grzesl/AngelCarol/README.md

# AngelCarol
AngelCarol is project that contains necessary information to build Angel statue that sings carols.
