grzesl/AngelCarol/Mechanical/Cover.FCStd

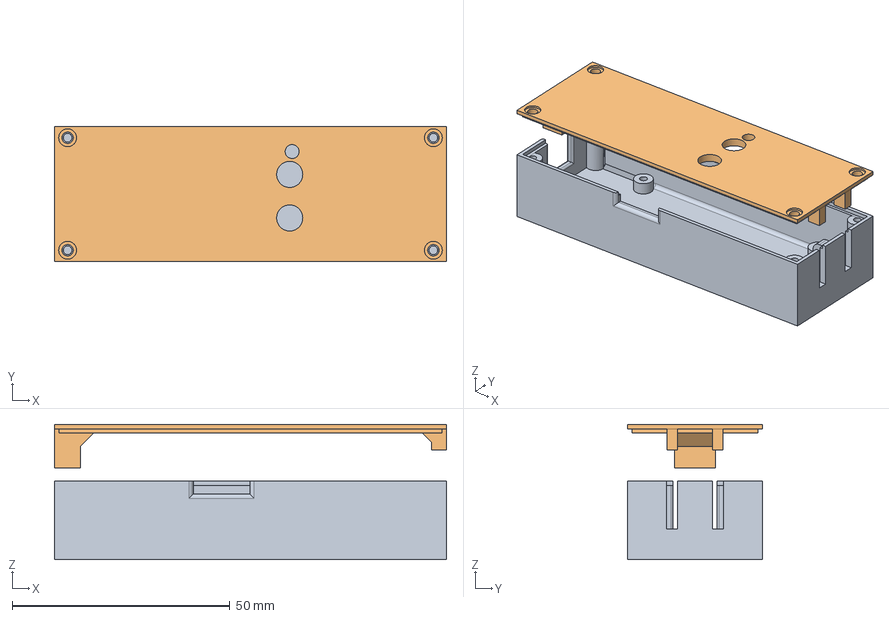
[picture p1: CAD file, 2024-12-02]
Mechanical/Cover.FCStd
90.0 x 31.0 x 31.0 mm
