grzesl/AngelCarol/Mechanical/PkHandler.FCStd

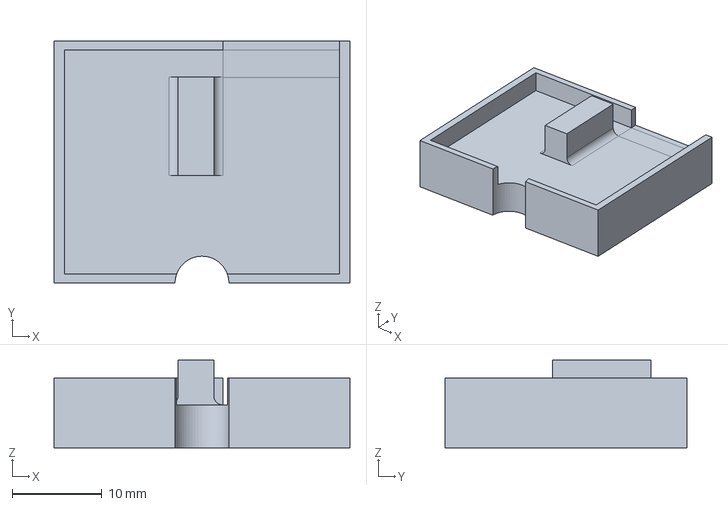
[picture p2: CAD file, 2024-11-30]
Mechanical/PkHandler.FCStd
33.0 x 27.0 x 9.80 mm
