grzesl/AngelCarol/Hardware/AngelCarol.kicad_pcb

## KiCad design Hardware/AngelCarol.kicad_pcb (2024-11-05)

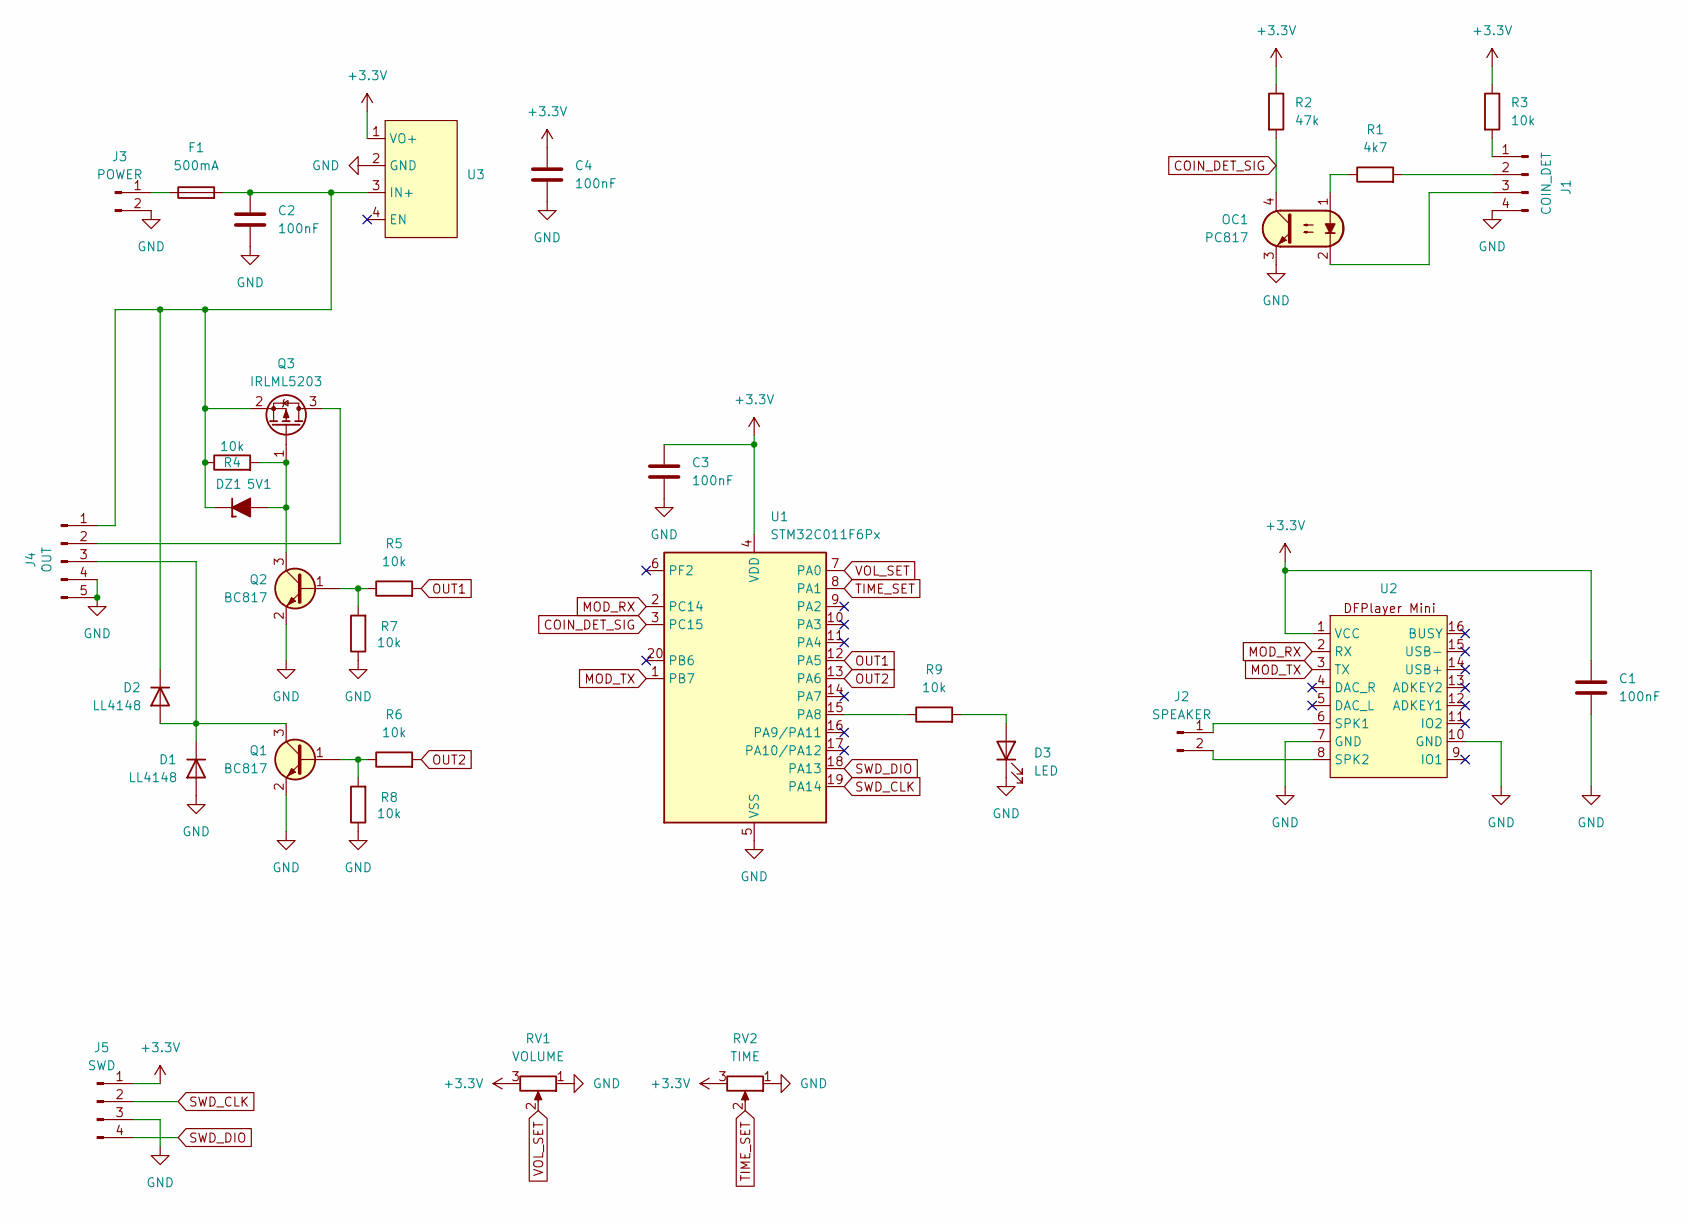
[picture p3: schematic AngelCarol.kicad_sch]

Parts:
C1, C2, C3, C4: 100nF; C_0805_2012Metric
D1, D2: LL4148; D_MiniMELF
D3: LED; LED_D3.0mm
DZ1: 5V1; D_T-1_P5.08mm_Horizontal
F1: 500mA; Fuse_1206_3216Metric_Pad1.42x1.75mm_HandSolder
J1: COIN_DET; PinHeader_1x04_P2.54mm_Vertical
J2: SPEAKER; PinHeader_1x02_P2.54mm_Vertical
J3: POWER; PinHeader_1x02_P2.54mm_Vertical
J4: OUT; PinHeader_1x05_P2.54mm_Vertical
J5: SWD; PinHeader_1x04_P2.54mm_Vertical
OC1: PC817; DIP-4_W7.62mm
Q1, Q2: BC817; SOT-23
Q3: IRLML5203; SOT-23
R1: 4k7; R_0805_2012Metric
R2: 47k; R_0805_2012Metric
R3, R4, R5, R6, R7, R8, R9: 10k; R_0805_2012Metric
RV1: VOLUME; POT_BLUE
RV2: TIME; POT_BLUE
U1: STM32C011F6Px; TSSOP-20_4.4x6.5mm_P0.65mm
U2: DFPlayerMini
U3: DCDC_PRESET

Connections:
+3.3V: C1.1, C3.1, C4.1, J5.1, R2.1, R3.1, RV1.3, RV2.3, U1.4 (VDD), U2.1 (VCC), U3.1 (VO+)
COIN_DET_SIG: OC1.4, R2.2, U1.3 (PC15)
GND: C1.2, C2.2, C3.2, C4.2, D1.2 (A), D3.1 (K), J1.4, J3.2, J4.4, J4.5, J5.3, OC1.3, Q1.2 (E), Q2.2 (E), R7.1, R8.1, RV1.1, RV2.1, U1.5 (VSS), U2.7 (GND), U2.10 (GND), U3.2 (GND)
MOD_RX: U1.2 (PC14), U2.2 (RX)
MOD_TX: U1.1 (PB7), U2.3 (TX)
unnamed: D1.1 (K), D2.2 (A), J4.3, Q1.3 (C)
unnamed: C2.1, D2.1 (K), DZ1.1 (K), F1.2, J4.1, Q3.2 (S), R4.1, U3.3 (IN+)
unnamed: D3.2 (A), R9.2
unnamed: DZ1.2 (A), Q2.3 (C), Q3.1 (G), R4.2
unnamed: J1.1, R3.2
unnamed: J1.2, R1.2
unnamed: J1.3, OC1.2
unnamed: J2.1, U2.6 (SPK1)
unnamed: J2.2, U2.8 (SPK2)
unnamed: F1.1, J3.1
unnamed: J4.2, Q3.3 (D)
unnamed: OC1.1, R1.1
unnamed: Q1.1 (B), R6.1, R8.2
unnamed: Q2.1 (B), R5.1, R7.2
unnamed: R9.1, U1.15 (PA8)
OUT1: R5.2, U1.12 (PA5)
OUT2: R6.2, U1.13 (PA6)
SWD_CLK: J5.2, U1.19 (PA14)
SWD_DIO: J5.4, U1.18 (PA13)
TIME_SET: RV2.2, U1.8 (PA1)
VOL_SET: RV1.2, U1.7 (PA0)

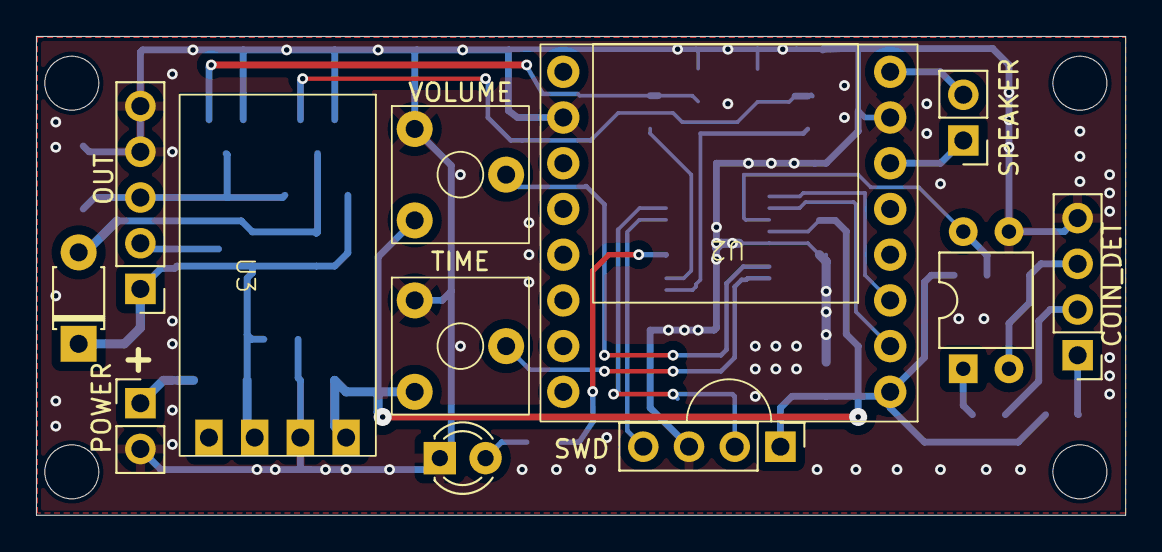
[picture p4: board AngelCarol.kicad_pcb from above]

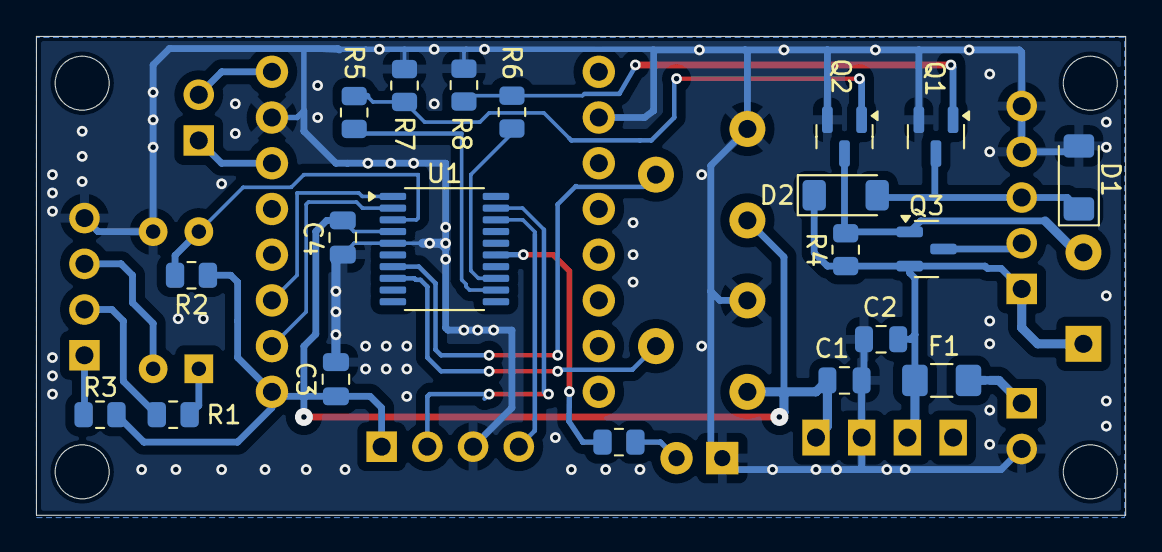
[picture p5: board AngelCarol.kicad_pcb from below]

Board: 2 copper layers, 60.5 x 26.6 mm, 32 parts (20 on the bottom side), 26 nets.
