grzesl/AngelCarol/(commit log)

2024-11-05 First version on PCB
    [AngelCarol.kicad_pcb, AngelCarol.kicad_sch]
2024-11-30 Tune some components values, add PK handler model
    [AngelCarol.kicad_sch, PkHandler.FCStd]
2024-12-02 Add Cover 3D model
    [Cover.FCStd]
2024-12-02 Add file with global board definition
2024-12-02 Some fix in schematic
    [AngelCarol.kicad_sch]
2024-12-03 Relay off aprox 10 sec after carol
